esden/open-bldc/source/libgovernor/README

Open-BLDC high speed debug protocol library.
