esden/open-bldc/source/firmware/README

This is firmware for the Open-BLDC (http://open-bldc.org)

Compilation
-----------

 $ make

Flashing
--------

1) Run OpenOCD in the directory where the *.bin file is located:

 $ openocd -f interface/flossjtag.cfg \
           -f board/open-bldc.cfg

NOTE: flossjtag.cfg is only an example. If you use another JTAG adapter
      choose a different config file.

2) Connect to OpenOCD, flash and reset the target:

 $ telnet localhost 4444
 > reset halt
 > flash write_image erase open-bldc.hex
 > reset
