esden/open-bldc/source/firmware/src/comm_process_hardware.c

/*
 * Open-BLDC - Open BrushLess DC Motor Controller
 * Copyright (C) 2010 by Piotr Esden-Tempski <piotr@esden.net>
 *
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
 * You should have received a copy of the GNU General Public License
 * along with this program.  If not, see <http://www.gnu.org/licenses/>.
 */

/**
 * @file   comm_process.c
 * @author Piotr Esden-Tempski <piotr@esden.net>
 * @date   Tue Aug 17 02:06:02 2010
 *
 * @brief  Commutation control userspace process implementation.
 *
 * This process is being called periodically from the main while loop and
 * generates commutation events.
 */

#include "types.h"

#include <lg/gpdef.h>
#include <lg/gprotc.h>

#include "gprot.h"
#include "driver/led.h"
#include "driver/debug_pins.h"
#include "driver/bemf_hardware_detect.h"
#include "comm_tim.h"
#include "comm_process.h"

#include "sensor_process.h"

volatile bool *comm_process_trigger;

/**
 * Internal state of the comm process struct.
 */
struct comm_process_state {
	volatile bool rising;	/**< Waiting for rising or falling edge of BEMF */
	bool closed_loop;	/**< Running in closed loop control flag */
	u32 detect_count;
};

/**
 * Comm process parameters
 *
 * @todo clean up documentation
 */
struct comm_params {
	s16 spark_advance;	 /**< advance commutation relative to calculated time */
	u16 direct_cutoff;	 /**< distance from the last calc time that makes the new invalid */
	u16 direct_cutoff_slope; /**< what is the control slope when outside the direct control window */
	u16 iir;		 /**< IIR value for the commutation time */
	u16 hold_off;		 /**< how many bemf samples after a commutation should be dropped */
};

static struct comm_process_state comm_process_state;	/**< Internal state instance */
struct comm_data comm_data;			/**< Public data instance */
struct comm_params comm_params;			/**< Parameters */
s32 new_cycle_time;				/**< New commutation time
						  temporary variable, @todo
						  remove */

bool comm_process_time_valid(void);

/**
 * Initialize commutation process
 */
void comm_process_init(void)
{

	gpc_setup_reg(GPROT_COMM_TIM_SPARK_ADVANCE_REG_ADDR,
		      (u16 *) & (comm_params.spark_advance));
	gpc_setup_reg(GPROT_COMM_TIM_DIRECT_CUTOFF_REG_ADDR,
		      &(comm_params.direct_cutoff));
	gpc_setup_reg(GPROT_COMM_TIM_IIR_POLE_REG_ADDR, &(comm_params.iir));

	comm_process_trigger = &bemf_hd_data.trigger;

	comm_process_state.rising = true;
	comm_process_state.closed_loop = false;
	comm_process_state.detect_count = 0;

	comm_data.bemf_crossing_detected = false;
	comm_data.calculated_freq = 0;
	comm_data.in_range_counter = 0;

	comm_params.spark_advance = COMMP__SPARK_ADVANCE;
	comm_params.direct_cutoff = 10000;
	comm_params.direct_cutoff_slope = 20;
	comm_params.iir = COMMP__IIR;
	comm_params.hold_off = 1;
}

/**
 * Reset commutation process internal state.
 */
void comm_process_reset(void)
{
	comm_process_state.detect_count = 0;
}

/**
 * Commutation process configuration
 *
 * @param rising true selects rising edge of bemf and false the falling edge of
 * the BEMF
 */
void comm_process_config(bool rising)
{
	comm_process_state.rising = rising;
}

/**
 * Reset and configure commutation process.
 *
 * @param rising true selects rising edge of BEMF and false the falling edge of
 * the BEMF
 */
void comm_process_config_and_reset(bool rising)
{
	comm_process_state.rising = rising;
}

/**
 * Switch on the closed loop control system
 */
void comm_process_closed_loop_on(void)
{
	comm_process_state.closed_loop = true;
}

/**
 * Switch off the closed loop control system
 */
void comm_process_closed_loop_off(void)
{
	comm_process_state.closed_loop = false;
}

/**
 * Main periodic body of the commutation process
 */
void run_comm_process(void)
{
	u32 big_freq = comm_tim_data.freq;
	u16 new_freq = (comm_tim_data.curr_time -
		comm_tim_data.prev_time);
	u32 big_new_freq = new_freq;

	big_new_freq += comm_params.spark_advance;

#ifdef PWM_SCHEME_12STEP
	big_new_freq /= 4;
#else
	big_new_freq /= 2;
#endif

	big_freq = big_freq * comm_params.iir;
	big_new_freq = (big_freq + big_new_freq) / (comm_params.iir + 1);

	if (comm_process_time_valid()) {
		comm_tim_data.freq = big_new_freq;
		(void)gpc_register_touched(GPROT_COMM_TIM_FREQ_REG_ADDR);

		comm_tim_update_freq();

		OFF(DP_EXT_SCL);
	} else {
		comm_tim_update_freq();
		OFF(DP_EXT_SCL);
	}

	if (comm_process_state.closed_loop) {

		comm_data.bemf_crossing_detected = true;
		comm_tim_trigger_comm = true;
	}
}

bool comm_process_time_valid(void) {
	/*
	 * check if we are in the range where the comm timer is able
	 * to operate
	 */
	if ((comm_tim_data.update_count > 1) ||
		((comm_tim_data.update_count == 1) &&
			(comm_tim_data.curr_time > comm_tim_data.prev_time))) {
		return false;
	}

	/*
	 * check if we are far away from the edge of the maximal time
	 * comm timer can work in so that we have enough freedom to operate
	 */
	if ((comm_tim_data.curr_time -
			comm_tim_data.prev_time) > (65535 - 1000)) {
		return false;
	}

	return true;
}

/**
 * Do we have enough information for calculating commutation times?
 */
bool comm_process_ready(void)
{

	if (!comm_process_time_valid()) {
		comm_process_state.detect_count = 0;
		return false;
	}

	comm_process_state.detect_count++;

	/*
	 * check if we detected enough valid transitions that we
	 * are comfortable to proceed with closed loop
	 */
	if (comm_process_state.detect_count < 20) {
		return false;
	}

	return true;
}
