esden/open-bldc/source/firmware/src/control_process.c

/*
 * Open-BLDC - Open BrushLess DC Motor Controller
 * Copyright (C) 2010 by Piotr Esden-Tempski <piotr@esden.net>
 *
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
 * You should have received a copy of the GNU General Public License
 * along with this program.  If not, see <http://www.gnu.org/licenses/>.
 */

/**
 * @file   control_process.c
 * @author Piotr Esden-Tempski <piotr@esden.net>
 * @date   Tue Aug 17 01:27:42 2010
 *
 * @brief  User space control process implementation.
 *
 * This process is being called periodically from the main while loop and
 * handles the high level control of the system. The main state machine of the
 * whole controller is implemented here.
 */

#include "types.h"
#include "config.h"

#include "comm_tim.h"
#include "pwm/pwm.h"
#include "comm_process.h"
#include "driver/led.h"

#include "cp_spinup.h"
#include "cp_idle.h"
#include "cp_aligning.h"
#include "cp_spinning.h"
#include "cp_error.h"

#include "control_process.h"

/* local function forward declarations */
static void control_process_handle_cb_state(enum control_process_cb_state cb_ret);

/* Note: control_process_<state>_cb is defined in external
 * <state> strategy that implements <state>.h.
 */

static struct control_process control_process;	/**< Internal state struct instance */

/**
 * Control process state callback function pointer definition.
 */
typedef enum control_process_cb_state (*cps_callback) (struct control_process *
						       cps);

/**
 * Control process event hook slot definition.
 */
struct cps_event_hook {
	bool *trigger;		                          /**< Trigger the callback should be called upon */
	cps_callback callback;		                  /**< Pointer to the callback function */
	/*@null@*/ cps_callback state_in_callback;	  /**< Pointer to the callback function */
	/*@null@*/ cps_callback state_out_callback;       /**< Pointer to the callback function */
};

static struct cps_event_hook control_process_cb_hook_register[cps_num_states];

/* function implementations */

/**
 * Register a callback function for given control process state.
 *
 * These are:
 * (see @ref control_process.h -> control_process_state)
 *
 * - cps_error
 * - cps_idle
 * - cpd_aligning
 * - cps_spinup
 * - cps_spinning
 *
 * The number of existing process states (currently 5) is stored in
 * cps_num_states.
 *
 * In order to register a callback for a specific process state, use
 * @code
 * control_process_register_cb(<state>, <callback fun>);
 * @endcode
 *
 * Example from @ref control_process_init():
 * @code
 * control_process_register_cb(cps_idle,
 * 			       control_process_idle_trigger,
 * 			       control_process_idle_cb);
 * @endcode
 */
void control_process_register_cb(enum control_process_state cp_state,
				 bool * trigger,
				 cps_callback callback_fun,
				 cps_callback state_in_callback_fun,
				 cps_callback state_out_callback_fun)
{
	control_process_cb_hook_register[cp_state].trigger = trigger;
	control_process_cb_hook_register[cp_state].callback = callback_fun;
	control_process_cb_hook_register[cp_state].state_in_callback =
	    state_in_callback_fun;
	control_process_cb_hook_register[cp_state].state_out_callback =
	    state_out_callback_fun;
}

/**
 * Initialize internal state of the control process
 * Also calls callback init functions for every
 * process state.
 */
void control_process_init(void)
{
	control_process_reset();

	cp_idle_init();
	cp_spinup_init();
	cp_aligning_init();
	cp_spinning_init();
	cp_error_init();
}

/**
 * Reset the internal state of the control process.
 * Also calls callback reset functions for every
 * process state.
 */
void control_process_reset(void)
{
	cp_idle_reset();
	cp_spinup_reset();
	cp_aligning_reset();
	cp_spinning_reset();
	cp_error_reset();

	control_process.state = cps_idle;
	control_process.ignite = false;
	control_process.kill = false;
	control_process.bemf_crossing_counter = 0;
	control_process.bemf_lost_crossing_counter = 0;
}

/**
 * Trigger motor ignition
 */
void control_process_ignite(void)
{
	control_process_reset();
	comm_tim_reset();
	control_process.ignite = true;
}

/**
 * Immediately kill the motor
 *
 * Calling this function will immediately stop sending any signals to the power
 * stage. Can be used for example when a fault is being detected.
 */
void control_process_kill(void)
{
	comm_process_closed_loop_off();
	pwm_off();
	comm_tim_trigger_comm = false;
	comm_tim_trigger_comm_once = false;
	control_process.kill = true;
	control_process.state = cps_idle;
}

/**
 * Main periodic control process body.
 *
 * It implements the main state machine of the motor controller.
 *
 * Calls registered callback functions according to the current
 * state of the control process.
 * If a callback function returns an invalid code, the callback
 * function for state cps_error is called.
 *
 * Exits the closed loop and kills the control process if a
 * callback function returns cps_cb_exit_control.
 *
 * If the control process state changes during a callback function,
 * the last state's state_out_callback and the current state's
 * state_in_callback function is called.
 *
 * Order is:
 *
 *   current state -> callback (sets next state)
 *   -> run_control_process notices state transition
 *   current state -> state out callback
 *   next state    -> state in  callback
 *   -> next call of run_control_process
 *   next state    -> callback
 *
 */
void run_control_process(void)
{
	enum control_process_cb_state cb_ret = cps_cb_error;
	static enum control_process_state last_state = cps_idle;

	if (*control_process_cb_hook_register[control_process.state].trigger) {
		*control_process_cb_hook_register[control_process.state].
		    trigger = false;
		cb_ret =
		    control_process_cb_hook_register[control_process.state].
		    callback(&control_process);
	}

	control_process_handle_cb_state(cb_ret);

	if (last_state != control_process.state) {
		// Callback changed state of control process, so
		// if set, we call the last state's state_out_callback ...
		if (control_process_cb_hook_register[last_state].
		    state_out_callback) {
			cb_ret =
			    control_process_cb_hook_register[last_state].
			    state_out_callback(&control_process);
			control_process_handle_cb_state(cb_ret);
		}
		// ... and the next state's state_in_callback
		if (control_process_cb_hook_register[control_process.state].
		    state_in_callback) {
			cb_ret =
			    control_process_cb_hook_register[control_process.
							     state].
			    state_in_callback(&control_process);
			control_process_handle_cb_state(cb_ret);
		}
	}

	last_state = control_process.state;
}

/**
 * Internal handler for reacting on the states returned
 * by state callback functions.
 */
void control_process_handle_cb_state(enum control_process_cb_state cb_ret)
{
	if (cb_ret == cps_cb_continue) {
		// Everything is fine
		return;
	}

	// Could also be implemented in error handling strategy:
	if (cb_ret == cps_cb_exit_control) {
		// Callback wants process to exit closed loop
		control_process_kill();
	} else if (cb_ret == cps_cb_resume_control) {
		// Callback wants us to enter closed loop
		comm_process_closed_loop_on();
	}

}
