esden/open-bldc/source/qgovernor/governormaster.cpp

/*
 * qgovernor - QT based Open-BLDC PC interface tool
 * Copyright (C) 2010 by Piotr Esden-Tempski <piotr@esden.net>
 *
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
 * You should have received a copy of the GNU General Public License
 * along with this program.  If not, see <http://www.gnu.org/licenses/>.
 */

extern "C" {
#include <lg/types.h>
#include <lg/gpdef.h>
#include <lg/gprotm.h>
}

#include "governormaster.h"

extern "C" {
void gpm_output_trigger(void *data);
void gpm_log_callback(void *data);
void gpm_register_changed(void *data, u8 addr);
void gpm_string_received(void *data, char *string, int size);
}

GovernorMaster::~GovernorMaster()
{
  delete reglog;
}

GovernorMaster::GovernorMaster()
{
    gpm_init(gpm_output_trigger, static_cast<void *>(this), gpm_register_changed, static_cast<void *>(this));
    gpm_set_string_received_callback(gpm_string_received, static_cast<void *>(this));
}

signed short GovernorMaster::pickupByte()
{
    return gpm_pickup_byte();
}

int GovernorMaster::sendSet(unsigned char addr, unsigned short data)
{
    return gpm_send_set(addr, data);
}

int GovernorMaster::sendGet(unsigned char addr)
{
    return gpm_send_get(addr);
}

int GovernorMaster::sendGetCont(unsigned char addr)
{
    return gpm_send_get_cont(addr);
}

int GovernorMaster::sendGetVersion(void)
{
    return gpm_send_get_version();
}

unsigned short GovernorMaster::getRegisterMapValue(unsigned char addr)
{
    return gpm_get_register_map_val(addr);
}

int GovernorMaster::handleByte(unsigned char byte)
{
    return gpm_handle_byte(byte);
}

void GovernorMaster::outputTriggerCB()
{
    emit outputTriggered();
}

void GovernorMaster::registerChangedCB(unsigned char addr)
{
    emit registerChanged(addr);
}

void GovernorMaster::newLog(const QString &name)
{
  reglog = new QGLogger(name);
  gpm_set_log(&gpm_log_callback, static_cast<void *>(this));
}

void GovernorMaster::stringReceivedCB(char *string, int size)
{
    emit stringReceived(QString(string));

    size = size; /* we are ignoring size I think that it is a bad idea :/ */
}

// The libgovernor callbacks use a void pointer to keep the address of
// the GovernorMaster instance; these callbacks then re-cast it to
// call the methods on the right instance.  

extern "C" {
void gpm_output_trigger(void *data)
{
    static_cast<GovernorMaster *>(data)->outputTriggerCB();
}

void gpm_register_changed(void *data, u8 addr)
{
    static_cast<GovernorMaster *>(data)->registerChangedCB(addr);
}

void gpm_log_callback(void *data)
{
  static_cast<GovernorMaster *>(data)->reglog->
    writeRegisters(&gpm_get_register_map_val);
}

void gpm_string_received(void *data, char *string, int size)
{
    static_cast<GovernorMaster *>(data)->stringReceivedCB(string, size);
}

}
