esden/open-bldc/source/firmware/test/blink_main.c

/*
 * Open-BLDC - Open BrushLess DC Motor Controller
 * Copyright (C) 2009 by Piotr Esden-Tempski <piotr@esden.net>
 *
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
 * You should have received a copy of the GNU General Public License
 * along with this program.  If not, see <http://www.gnu.org/licenses/>.
 */

/**
 * @file   blink_main.c
 * @author Piotr Esden-Tempski <piotr@esden.net>
 * @date   Tue Aug 17 01:47:20 2010
 *
 * @brief  Blink test implementation
 *
 */

#include <libopencm3/stm32/f1/gpio.h>

#include "types.h"
#include "driver/mcu.h"
#include "driver/led.h"

/**
 * Crude delay implementation.
 *
 * Just burn some MCU cycles
 *
 * @param delay "time" to wait
 */
static void my_delay(unsigned long delay)
{

	while (delay != 0) {
		delay--;
		__asm("nop");
	}
}

/**
 * Turn on LED by id.
 *
 * @param id LED id
 */
static void led_on(int id)
{
	switch (id) {
	case 0:
		ON(LED_RED);
		break;
	case 1:
		ON(LED_GREEN);
		break;
	case 2:
		ON(LED_BLUE);
		break;
	case 3:
		ON(LED_ORANGE);
		break;
	}
}

/**
 * Turn off LED by id
 *
 * @param id LED id
 */
static void led_off(int id)
{
	switch (id) {
	case 0:
		OFF(LED_RED);
		break;
	case 1:
		OFF(LED_GREEN);
		break;
	case 2:
		OFF(LED_BLUE);
		break;
	case 3:
		OFF(LED_ORANGE);
		break;
	}
}

/**
 * Blink test main function
 *
 * @return Nothing really...
 */
int main(void)
{
	int i, j, led_id;

	mcu_init();
	led_init();

	led_id = 0;

	while (true) {
		for (j = 0; j < 20; j++) {
			for (i = 0; i < 125; i++) {
				led_on(led_id);
				my_delay((unsigned long)(50 * j));
				led_off(led_id);
				my_delay((unsigned long)(1200 - 50 * j));
			}
		}
		for (j = 0; j < 20; j++) {
			for (i = 0; i < 125; i++) {
				led_off(led_id);
				my_delay((unsigned long)(200 + 50 * j));
				led_on(led_id);
				my_delay((unsigned long)(1000 - 50 * j));
			}
		}
		led_off(led_id);
		led_id++;
		led_id %= 4;
	}
}
