esden/open-bldc/source/utils/olconf/src/register_config_builder.cpp

/*
 * olconf - yamlgen based Open-BLDC configuration header generator
 * Copyright (C) 2010 by Tobias Fuchs <twh.fuchs@gmail.com>
 *
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
 * You should have received a copy of the GNU General Public License
 * along with this program.  If not, see <http://www.gnu.org/licenses/>.
 */

#include <olconf/register_config_builder.hpp>
#include <olconf/register_config.hpp>
#include <olconf/register_group_config.hpp>
#include <olconf/abstract_register_config_runner.hpp>

#include <yamlgen/config_node.hpp>
#include <yamlgen/abstract_config_runner.hpp>
#include <yamlgen/exception/builder_exception.hpp>


namespace YAMLGen { 
namespace OBLDC { 

void
RegisterConfigBuilder::parse(ConfigNode const & config)
{
	ConfigNode root;
	ConfigNode::const_iterator root_it = config.find("config_root");
	if(root_it != config.end()) { 
		root = (*root_it).second;
	}
	else { 
		throw BuilderException("Could not find config_root", config.context());
	}
	parse_partial(root);
}

void
RegisterConfigBuilder::parse_partial(ConfigNode const & config_node)
{
	ConfigNode::const_iterator it_groups  = config_node.begin(); 
	ConfigNode::const_iterator end_groups = config_node.end(); 
	for(; it_groups != end_groups; ++it_groups) 
	{ 
		RegisterGroupConfig group = RegisterGroupConfig((*it_groups).first);
		
		ConfigNode group_config = (*it_groups).second;
		group.set_properties(group_config.values());

		if(group.has_property("description")) { 
			group.set_description(group["description"]);
		}
		
		ConfigNode registers = (*it_groups).second; 
		ConfigNode::const_iterator reglist = registers.find("registers"); 
		if(reglist == registers.end()) { 
			throw BuilderException("No entry 'registers:' found", registers.context());
		}
		ConfigNode register_list = (*reglist).second; 
		
		ConfigNode::const_iterator it_regs  = register_list.begin(); 
		ConfigNode::const_iterator end_regs = register_list.end(); 
		
		for(; it_regs != end_regs; ++it_regs) { 
			RegisterConfig reg = RegisterConfig((*it_regs).first);
			ConfigNode properties = (*it_regs).second; 
			reg.set_properties(properties.values());
			
			if(!reg.has_property("register")) { 
				throw BuilderException("No property 'register: <index>' found", 
															 properties.context());
			}
			if(!reg.has_property("label")) { 
				throw BuilderException("No property 'label: <string>' found", 
															 properties.context());
			}
			
			WidgetConfig widget; 
			if(properties.has_node("widget")) { 
				ConfigNode widget_properties = properties.node("widget");
				widget.set_properties(widget_properties.values());
				if(!widget.has_property("class")) { 
					throw BuilderException("No property 'class: <string>' found", 
																 widget_properties.context());
				}
			} 
			else {
				throw BuilderException("No property 'widget: <widget attribs>' found", 
															 properties.context());
			}
			reg.set_widget(widget); 
			
			group.add_register(reg); 
		}
		m_register_groups.push_back(group);
#if defined(LOG) && LOG == DEBUG
		group.log(); 
#endif
	}
}

void 
RegisterConfigBuilder::run(AbstractRegisterConfigRunner & runner) 
{
	runner.run(this); 
}

} /* namespace OBLDC */
} /* namespace YAMLGen */
