esden/open-bldc/(commit log)

2008-12-13 First very basic shot at the schematics of open-bldc
    [open-bldc.sch]
2008-12-13 Splitted ground around the shunt. So it is easier later on.
    [open-bldc.sch]
2008-12-13 Added i2c connector
    [open-bldc.sch]
2008-12-14 Now we are using AT90PWM3 instead of atmega8. Additionally overcurrent detection happenѕ discretly now.
    - Renamed GND1 in the symbol of at90pwm to GND.
    - Exchanged atmega8 with AT90PWM3
    - Adapted all circuits to use the examples in AVR 492 Application Note
    - We can measure current but are using an opamp to detect overcurrent instantly
    - We now have 4 indicator LED's (I love LED's ^^)
    - Serial connector removed because it is not needed anymore. Serial is on the same pins as the programmer.
    [open-bldc.sch]
2008-12-14 Added the url's of the Application Notes used in the circuit design to the README
2008-12-15 Changed again everything around. Now the uc is an atmega168, the current measurement is gone, back to a similar to the old schematic bemf circuit, compleatly new phase control with drivers and fets
    [open-bldc.sch]
2008-12-15 Many improvements! Changed connectors to smd pads, added battery voltage measurement circuit, added another row of fets, power and phases are pads now, moved led's to other pins of the atmega, and pr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
    [open-bldc.sch]
2008-12-16 Changed the resistors of the commutation detection and added capacitors to smooth the signals, connected the lower side of the phase drivers to GND, fixed most of the ERC warnings, Quarz replaced wit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
    [open-bldc.sch]
2008-12-16 Changed all resistor and capacitor packages to 0402 and LED packages to 0603.
    [open-bldc.sch]
2008-12-16 Changed the resistors and capacitors back to 0603 ... the 0402 are too small after all. ^^ Changed R18 to 10k
    [open-bldc.sch]
2008-12-26 Cleaned up the names of R's and C's so that they are in a somehow sane order. And probably some more other cleanups.
    [open-bldc.sch]
2008-12-26 Added a first shot at the board layout and routing of Open BLDC. There are still some DRC Errors for Stop Mask that may have to be resolved.
    In this version of the board the low and high side fets are placed on two different sides of the board. (has to be discussed)
    [open-bldc.brd]
2008-12-26 Added "Fet drivers" and "N-Channel vs N- and P-Channel MOSFETs" sections to design discussions. (TODO: these sections need proper explanations from electrical engeneers or someone with knowledge why 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
2008-12-26 Added a board layout with all fets on one side. This board layout is not finished, but added as reference and basis for further development.
    [open-bldc-fets-one-side.brd]
2008-12-26 Moved current schematics and board layouts to a new subdirectory. Because I want to start working on alternative boards.
    [open-bldc-fets-one-side.brd, open-bldc.brd, open-bldc.sch]
2008-12-26 Added copyright and license notes to the board layouts of open-bldc-normal.
    [open-bldc-fets-one-side.brd, open-bldc.brd]
2008-12-26 Added schematics of the open-bldc mini version.
    [open-bldc.sch]
2008-12-29 Rerouted everything from scratch to make the board smaller. Now it is 26mm by 60mm instead of 30 by 100. It is a big improovement.
    [open-bldc.brd]
2009-04-11 Fixed License strings in the schematics and pcb layouts
    [open-bldc.brd, open-bldc.sch]
2009-04-19 Added test code for the open-bldc breadboard prototype.
2009-04-19 Now generating real 6Step PWM signal!
2009-04-20 Moved pwm initialization into it's own function.
2009-04-20 First working uart tx.
2009-04-22 Moved pwm and usart related stuff from main.c to their own files.
2009-04-25 Added more led debug blocks. Enabled com handle block.
2009-04-25 Increased resolution of enforced comm timer setting.
2009-04-25 PWM duty cycle can now be changed through usart.
2009-04-25 Moved tim1_trg_com_irq_handler to the pwm module.
2009-04-25 Removed all the empty interrupt handler routines.
2009-04-26 Some little tweaks. (Maiden run: result the motor turns!)
    Increased the resolution of forced commutation. Increased the resolution
    of pwm. Some little parameter tweaks. The motor, in most cases, starts
    to turn by it self.
2009-04-27 Moved old pcb designs to discarded folder. Not deleting to leave it for reference.
    [open-bldc-fets-one-side.brd, open-bldc.brd, open-bldc.sch]
2009-04-27 First steps in redesigning the hardware to use stm32.
    [open-bldc.brd, open-bldc.sch]
2009-04-27 Fixed license.
    [open-bldc.brd, open-bldc.sch]
2009-04-27 Added new commutation detection circuitry. And small fixes.
    [open-bldc.brd, open-bldc.sch]
2009-04-28 Work on the commutation detection circuitry.
    [open-bldc.brd, open-bldc.sch]
2009-04-29 Refactoring: Moved the commutation algorithm and phase setting functions to their own modules. Created config.h with compile time settings.
    This should it make much eaiser to implement different pwm schemes that
    can be tested against each other. And compile time configuration is now
    a bit easier due to config.h.
2009-05-01 Renamed current pwm scheme to it's real name.
2009-05-01 Added table with pwm scheme zone configurations.
2009-05-01 Removed the freewheeling stuff again. It just does not work.
    I need to take a deeper look into it later.
    [pwm.c, usart.c]
2009-05-01 Implemented 12step pwm_on_pwm and 6step on_pwm schemes.
2009-05-01 Added a reload of TIM1 when commutating to get rid of a wierd oscilating noise caused by non aligned PWM signals.
2009-05-03 Implemented pwm_on scheme.
2009-05-04 Changed enabled PWM scheme to 12step pwm_on_pwm. Should stay default in the repo.
2009-05-04 Added first test code for pwm triggered adc. Commutation detection we are coming!
2009-05-06 Added some svg graphics depicting the different pwm schemes.
2009-05-06 Added a voltage divider, and now using two schottkey diodes for cutoff in the comm detect circuitry.
    We may have to measure the phase voltages in pwm on times so the voltage
    divider will be very useful. The ADC seems to be robust enough to
    withstand the voltage overshoot when using schottkey diodes for upper
    voltage cutoff.
    [open-bldc.brd, open-bldc.sch]
2009-05-08 Added an optional filter capacitor to bemf circuitry, added current sensing and replaced voltage regulator with a dual channel 3v3, 5v.
    [open-bldc.brd, open-bldc.sch]
2009-05-14 Ported Open-BLDC to libstm32 3.0.0
2009-05-21 Added pullups to jtag interface. Added USB connector and USB disconnect circuit.
    [open-bldc.brd, open-bldc.sch]
2009-06-16 Added current sensing circuitry to phases. Added connectors between the logic board and power stage. Some other minor changes.
    [open-bldc.brd, open-bldc.sch]
2009-06-16 Replaced the SO8 Mosfets with D2PAK. Now only one bridge row instead of three.
    [open-bldc.brd, open-bldc.sch]
2009-06-16 Replaced the edge connectors between logic and powerstage with 1.27mm single pinheaders. These will be put on each side of the logic board. This is mechanically more robust. The smaller pitch is also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
    [open-bldc.brd, open-bldc.sch]
2009-06-16 Fixed the LED connections to the MCU.
    [open-bldc.brd, open-bldc.sch]
2009-06-17 Replaced bootstrap caps with tantals, 1uF with smaller packages, elko with two tantals (last one is mechanically more robust).
    [open-bldc.brd, open-bldc.sch]
2009-06-17 Replaced the strange 3v3, 5v voltage regulator with two single, more common, ones.
    [open-bldc.brd, open-bldc.sch]
2009-06-17 Replaced JTAG and I2C connectors with 1.27mm pitch edge connectors. Moved USART lines from the JTAG connector to it's own one.
    [open-bldc.brd, open-bldc.sch]
2009-06-18 Replaced the single resistors for LED's with a resistor array. (more such replacements to come) Replaced three of the LED's with one RGB LED.
    [open-bldc.brd, open-bldc.sch]
2009-06-18 Replaced some more resistors with arrays to optimize space usage.
    [open-bldc.brd, open-bldc.sch]
2009-06-18 Moved the 3V3 regulator behind 5V regulator to decrese power usage.
    [open-bldc.brd, open-bldc.sch]
2009-06-18 BEMF and phase current are now selectable using smd jumpers.
    [open-bldc.brd, open-bldc.sch]
2009-06-18 Fixed typo in copyright/license notice.
    [open-bldc.sch]
2009-06-18 Reordered the crircuitry a bit. Designated Powerstage and Logic board circuitry parts.
    [open-bldc.sch]
2009-06-18 Reordered pins on the i2c connector. Added 3V3 and 5V to the usart connector.
    [open-bldc.brd, open-bldc.sch]
2009-06-18 Removed external oscilator. We do not need it. The maximum clock can be acheved also with the internal clock source.
    [open-bldc.brd, open-bldc.sch]
2009-06-18 Cleaned up the power supply and reset circuitry of the STM32.
    [open-bldc.brd, open-bldc.sch]
2009-06-18 Added power supply circuit for the power stage.
    [open-bldc.brd, open-bldc.sch]
2009-06-18 Removed rectification diodes from current sensor circuitry.
    [open-bldc.brd, open-bldc.sch]
2009-06-18 Removed HAL pins from the powerstage to logic connector. We really can do everything sensorless. Added 12V and powerstage id instead.
    [open-bldc.brd, open-bldc.sch]
2009-06-18 Moved LED1 and LED2 to pwm output pins for some fading fun.
    [open-bldc.brd, open-bldc.sch]
2009-06-18 Removed usb_disc circuitry. We don't really need it. Left only the pullup so that open-bldc gets detected as a full speed device.
    [open-bldc.brd, open-bldc.sch]
2009-06-18 Moved USB pullup behind the series resistor where it should be. Moved the pins of i2c back to the old version to match UAVP NG order. Renamed USB Connector to U3.
    [open-bldc.brd, open-bldc.sch]
2009-06-18 Removed brd file. It has to be remade from scratch anyways.
    [open-bldc.brd]
2009-06-18 Moved shottkey voltage clamping diodes from bemf circuitry to the logic board to protect the I/BEMF lines.
    [open-bldc.sch]
2009-06-18 Replaced usart connector with molex microblade.
    [open-bldc.sch]
2009-06-19 Replaced the 3v3 regulator with LP2992 to save space.
    [open-bldc.sch]
2009-06-19 Added 12V charge pump for bridge driver power supply.
    [open-bldc.sch]
2009-06-19 Removed lowpass capacitors from the current sensors. It is not needed, we use the filter pin on the sonsors.
    [open-bldc.sch]
2009-06-19 Added buffer opamps to I/BEMF and I_SENSE lines coming from the powerstage.
    [open-bldc.sch]
2009-06-19 Added jumpers to make it possible to disconnect the opamps for testing. Also added a 2way jumper to the power supply of the bridge drivers to make testing that also easier.
    [open-bldc.sch]
2009-06-19 Moved the complete schematic to a subdirectory so that we can start creating independant projects for the logic board and power stage board.
    [open-bldc.sch]
2009-06-21 Added STM32f101x-LQFP48 to the library. Preparing to replace the one in the schematic with a single piece.
2009-06-21 Some little fixes based on ERC check.
    [open-bldc.sch]
2009-06-21 Some little tweeks on the STM32 symbol in the library. Replaced the scattered STM32 symbol with the single one contained in the open-bldc.lbr.
    [open-bldc.sch]
2009-06-21 Connected USB_+5V to the +5V rail.
    [open-bldc.sch]
2009-06-21 Replaced single solder jumpers with smaller ones. The same style as the SJ2 ones.
    [open-bldc.sch]
2009-06-21 Added an HC49UP crystal. As it seems we need an external crystal at the end. The internal 8MHz quarz is not exact enough for USB and the maximal clock one can get out of it is 64MHz and not 72Mhz. :(
    [open-bldc.sch]
2009-06-21 Connected SHDN pin of the bridge driver charge pump to gnd. Otherwise the charge pump is always off.
    [open-bldc.sch]
2009-06-21 Connected the PowerStage_ID to +3V3 is better then +12V. :)
    [open-bldc.sch]
2009-06-21 Added >NAME and >VALUE to ST662A charge pump symbol.
    [open-bldc.sch]
2009-06-21 Corrected series resistor values of the USART connector.
    [open-bldc.sch]
2009-06-21 Replaced the duo array resistors with single ones. Replaced the 0603 led resistor array with 1206.
    [open-bldc.sch]
2009-06-22 Corrected the name of the voltage divider net name (V_BATT) on the powerstage.
    [open-bldc.sch]
2009-06-22 Added another stabilization tantal for the bridge driver, +12V supply, rail.
    [open-bldc.sch]
2009-06-22 Renamed the nets behind current sensors to make routing easier.
    [open-bldc.sch]
2009-06-22 Started to layout the powerstage. (Some preliminary tests)
    [open-bldc-power.brd, open-bldc-power.sch]
2009-06-22 Layouted the bridge drivers on the powerstage.
    [open-bldc-power.brd]
2009-06-23 Nearly finished the first approach to the powerstage routing. The chargepump and global current sensor are not routed yet.
    [open-bldc-power.brd, open-bldc-power.sch]
2009-06-24 Routed the charge pump. Changed the orientation of the logic board, it seems to make everything much more streightforward. Reordered some pins on the power/sensor connector, to clean up some ugly mes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
    [open-bldc-power.brd, open-bldc-power.sch]
2009-06-24 Added Open-BLDC logo and some text to the board layout. Just for the fun of it.
    [open-bldc-power.brd]
2009-06-24 Corrected pinouts of the logic to power connection headers.
    [open-bldc.sch]
2009-06-24 Created eagle project for the logic board layout.
    [open-bldc-logic.brd, open-bldc-logic.sch]
2009-06-24 Added version string to the power stage layout.
    [open-bldc-power.brd]
2009-06-24 Replaced the crystal resonator with a small oscillator.
    [open-bldc-logic.brd, open-bldc-logic.sch, open-bldc.sch]
2009-06-24 Removed one of the big tantals on the logic board, replaced the opamp with a smaller tssop-14 version. Everything to save space. Layouting the logic board will be a nice puzzle anyways.
    [open-bldc-logic.brd, open-bldc-logic.sch, open-bldc.sch]
2009-06-24 Sorted all the components on the logic board together in functional pieces and made preliminary positioning.
    [open-bldc-logic.brd, open-bldc-logic.sch]
2009-06-26 Started routing. JTAG, I2C/PWM, USART and USB/CAN connectors are routed now.
    [open-bldc-logic.brd]
2009-06-26 Now the right logic brd layout should be commited. Removed the jumpers after the opamps to save even more space on the logic board.
    [open-bldc-logic.brd, open-bldc-logic.sch, open-bldc.sch]
2009-06-26 Further work on routing. LED's and the +5V of the USB/CAN connector are still missing. (nearly finished)
    [open-bldc-logic.brd, open-bldc-logic.sch]
2009-06-27 More routing work on the logic board. 5airwires to go.
    [open-bldc-logic.brd, open-bldc-logic.sch]
2009-06-28 Finished routing the logic board!
    [open-bldc-logic.brd]
2009-06-28 Added license string, restrict layer to the logo and some GND vias to the logic board.
    [open-bldc-logic.brd]
2009-06-28 Propagated the changes made in the logic circuit during routing.
    [open-bldc-power.brd, open-bldc-power.sch, open-bldc.sch]
2009-06-28 Finished routing the powerstage!
    [open-bldc-power.brd]
2009-06-28 Fixed wire angles in the logic board.
    [open-bldc-logic.brd]
2009-06-28 Incresed isolate on the powerstage.
    [open-bldc-power.brd]
2009-06-28 Corrected mechanical dimensions of the powerstage to metric.
    [open-bldc-power.brd]
2009-06-28 Corrected some mechanical data to match design rules and fixed angles in the powerstage.
    [open-bldc-power.brd]
2009-06-28 Added teardrop versions of the boards. Fixed some minor positioning on the logic board to make the board conform to the design rules after adding teardrops.
    [open-bldc-logic-teardrops.brd, open-bldc-logic.brd, open-bldc-power-teardrops.brd]
2009-06-29 Added version string to the logic board.
    [open-bldc-logic-teardrops.brd, open-bldc-logic.brd]
2009-06-29 Increased isolate on the logic board.
    [open-bldc-logic-teardrops.brd, open-bldc-logic.brd]
2009-06-30 Corrected the footprint of the LED resistor array.
    [open-bldc-logic.brd, open-bldc-logic.sch, open-bldc.sch]
2009-07-01 On public request started layouting a mini version of the powerstage using SO8 mosfets.
    [open-bldc-powermini.brd, open-bldc-powermini.sch]
2009-07-08 Added lots of vias to the powerboard and some to the logic board, so that the ground planes act less as antennas. Fixed layers in texts (above the copper layer it has to be resist not restrict) and m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
    [open-bldc-logic-teardrops.brd, open-bldc-logic.brd, open-bldc-logic.sch, open-bldc-power-teardrops.brd, open-bldc-power.brd, open-bldc-power.sch, open-bldc.sch]
2009-07-08 Added a jtag adapter to convert from the very common 20pin connector to the 10pin connector used on the open-bldc logic board.
    [jtag_adapter.brd, jtag_adapter.sch]
2009-07-09 added Makefiles for batch generation of gerbers and panels
    [layout.cfg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]
2009-07-10 Changed gerber generating makefile to use the teardrop version of the boards and added jtag_adapter board. Changed the layout of the panel to contain 4 open-bldc's on one panel and one jtag adapter.
    [layout.cfg]
2009-07-16 Added io protection resistors to the schematics. Still need to squeeze them into the logic board.
    They may not be really necessary but the atmel application note which is
    using the IR2101 bridge drivers has them. So to be sure that nothing
    goes wrong we really should add them. On the other hand I had some
    problems on the smd prototype of open-bldc which burnt the bridge
    drivers it is unlikely but this may be the reason for that. One can
    still bridge them when assembling.
    [open-bldc-logic.brd, open-bldc-logic.sch, open-bldc.sch]
2009-07-17 Squeezed in the 6 resistors for io protection of the bridge drive signals.
    Now we really should be ready for ordering the boards!
    [open-bldc-logic.brd]
2009-07-17 Updated the teardrop version of the logic board.
    [open-bldc-logic-teardrops.brd, open-bldc-logic.brd]
2009-07-26 Add README for Open-BLDC schematics/layouts implemented using gEDA/pcb.
2009-07-26 Add initial gschemrc file, set print size to A4.
2009-07-26 Add initial gsch2pcb.cfg, the config file for gsch2pcb.
    [gsch2pcb.cfg]
2009-07-26 Add initial schematics file for Open-BLDC, currently empty.
    [open-bldc.sch]
2009-07-26 Add project Makefile which can generate PDF/PS/Gerber/etc. output.
2009-07-26 Add some meta-data such as title, license, version to the schematics.
    [open-bldc.sch]
2009-07-26 Add a bunch of symbols to the schematics.
    [open-bldc.sch]
2009-07-26 Add parts of the "LED Indicators" schematics component.
    [open-bldc.sch]
2009-07-26 Add parts of the BEMF stuff.
    [open-bldc.sch]
2009-07-26 Add some parts of the power stage.
    [open-bldc.sch]
2009-07-26 Generate symbols before exporting schematics.
2009-07-26 Change pin order (to match physical chip) and add name/PDF/etc.
2009-07-26 Add some more schematics details, fix descriptions etc.
    [open-bldc.sch]
2009-07-26 Add an IR2101 IC.
    [open-bldc.sch]
2009-07-27 Fixed two typos in the STM32 symbol.
    [open-bldc-logic.sch, open-bldc.sch]
2009-07-27 Fixed a typo. ^^
    [gsch2pcb.cfg]
2009-07-27 Add symbol for the LQFP48 STM32F103xx microcontroller.
2009-07-27 Rearrange parts a bit.
    [open-bldc.sch]
2009-07-27 Add a symbol for a simple 10 pin JTAG connector.
2009-07-27 Add JTAG connector and surrounding stuff.
    [open-bldc.sch]
2009-07-27 Add LP2992 and surrounding parts.
    [open-bldc.sch]
2009-07-27 Add JP21 and JP22.
    [open-bldc.sch]
2009-07-27 Add ACS712 and surrounding components.
    [open-bldc.sch]
2009-07-27 Add ST662A and surrounding components.
    [open-bldc.sch]
2009-07-27 Rearrange some parts and make them more compact.
    [open-bldc.sch]
2009-07-27 Rearrange some more parts and make them more compact.
    [open-bldc.sch]
2009-07-27 Make JTAG connector smaller, fix cosmetics in other symbols.
2009-07-27 Adapt schematics for the now-smaller JTAG connector.
    [open-bldc.sch]
2009-07-27 Add symbol for a tiny 10-pin connector, the defaults are a bit too large.
2009-07-27 Use new tiny 10pin connectors.
    [open-bldc.sch]
2009-07-29 Started v0.2 version of the circuitry.
    [open-bldc.sch]
2009-07-29 Removed USB.
    [open-bldc.sch]
2009-07-30 Added CAN transceiver, replaced the I2C pinheader with molex connector, added jumpers to select between I2C and CAN on the former I2C connector.
    [open-bldc.sch]
2009-08-02 Add tiny 3-pin connector symbol.
2009-08-02 Use new tiny 3-pin connector, rearrange some components.
    [open-bldc.sch]
2009-08-02 Add a symbol for a dual solder-jumper (you can solder 1-2 or 2-3).
2009-08-02 Use the new solder-jumper (SJ2) symbol.
    [open-bldc.sch]
2009-08-02 Use 'refdes' tag where appropriate, not 'value'. Fix a symbol.
    [open-bldc.sch]
2009-08-02 Make schematics even more compact, fix typo in JP11/JP12.
    [open-bldc.sch]
2009-08-02 Rearrange more stuff and add an SMT32 to the schematic.
    [open-bldc.sch]
2009-08-02 Start populating STM32 pins.
    [open-bldc.sch]
2009-08-02 Add a dot to the NRST pin, it's active-low.
2009-08-02 Add some more circuitry around the STM32 symbol.
    [open-bldc.sch]
2009-08-02 Moved v0.2 schematic into eagle subdir. (preparing for gEDA support)
    [open-bldc.sch]
2009-08-08 Fixed breadboard prototype readme. It was still talking about the blink demo for the Olimex test board.
2009-08-09 Started the open-bldc firmware based on the breadboard prototype code. For the start it blinks with the red led.
2009-08-09 Factored out the LED stuff into the led module. Now all leds are blinking in sequence.
2009-08-09 Added usart support. Usart is echoing received data back to the sender and with every received byte the RED led is toggled.
2009-08-14 Added led toggling macros.
2009-08-14 Added pwm generation code.
2009-08-15 Enabled the tim1 comm interrupt.
2009-08-15 Now the phase pwm output should be force commutated with 73.24 Hz. (Just for testing)
2009-08-15 Switched to arm-elf compiler.
2009-08-15 Moved all pwm generation code into its own directory to clean up a bit.
2009-08-15 Now the LED stuff should be fixed finally...
    [led.h]
2009-08-16 Added some of the needed control through usart:
    <Space>: Emergency stop
    a: Commutate once
    b: Enable forced commutation timer
    c: Disable forced commutation timer
    h: Increase pwm duty cycle
    t: Decrese pwm duty cycle
    n: Decrese forced commutation frequency
    s: Increse forced commutation frequency
2009-08-19 Added OC4 to TIM1, it will become the trigger for ADC. The CC interrupt is not really needed but is nice for debugging purposes.
2009-08-19 Fixed LED output a little more. Now everything seems to work as it should. Even such a simple thing can also be messed up in infinite number of ways.
    [led.h, main.c, pwm.c]
2009-08-19 Red LED fading as heartbeat.
2009-08-21 Added BEMF commutation detection and timer based commutation time prediction. Some more keys for terminal control of BEMF based commutation.
    New keyboard keys:
    'r': Increse delay between pwm and adc trigger
    'l': Decrese delay between pwm and adc trigger
    'v': Increse BEMF detection threshhold
    'z': Decrese BEMF detection threshhold
    'p': Enable BEMF based commutation
2009-08-22 Added an IIR filter to the adc BEMF sampling.
2009-09-05 Bit of whitespace fixing.
    [adc.c, comm_tim.c]
2009-09-19 Upped the uart speed to 500kBaud we will need it for adc output monitoring very very soon.
2009-09-20 Started implementing governor (the PC tool for Open-BLDC) the backend of it will become libgovernor in the future to make it easy to create gui(s).
2009-09-20 Started implementing Open-BLDC protocol.
2009-09-20 Fixed some compiler warnings and an error preventing governor from compiling.
    [main.c]
2009-09-28 Added another footprint for the bridge driver. Thanks to David Brodski.
2009-10-21 Added so8 mosfet.
2009-10-21 Many improvements and changes.
    - Removed 5V linear vreg from the logic board.
    - Removed opamp from logic board.
    - Rerouted 5V supply of the uart connector and powerstage through a
    diodes.
    - Replaced JTAG connector with a molex microblade.
    - Replaced resistor array for LED's with discrete resistors.
    - Replaced D2PAK mosfets with SO8 type.
    - Removed unnecessary current sensor on phase C
    [open-bldc.sch]
2009-10-21 Added part representing the open-bldc logo.
2009-10-22 Splitted logic board and powerstage finally for good. :)
    [logic.sch, open-bldc.sch, pstage.sch]
2009-10-22 Replaced solderjumpers with fancy ones. Fixed footprint of some resistors.
    [logic.sch]
2009-10-22 Started layouting the logic board. (Too many changes to just modify the v0.1)
    [logic.brd]
2009-10-23 Some more layout work on the logic board. Replaced the BAS20 diodes with CDBU0130 0603 footprint diodes.
    [logic.brd, logic.sch]
2009-10-27 Finished routing the logic lines of the logic board. Only the two inner power layers missing.
    [logic.brd, logic.sch]
2009-10-27 Added GND and +3V3 layer. Little cosmetic cleanups. Almost finalized logic board V0.2.
    [logic.brd]
2009-11-16 Added digital encoder connector to the logic board.
    [logic.brd, logic.sch]
2009-11-16 Some more work on the so8 based powerstage.
    [pstage.brd, pstage.sch]
2009-11-18 Interrupt handlers are now weak pointers. Should make development bit easier.
2009-11-26 Layouted the silkscreen on the logic board to make a placeplan and maybe use it on future boards. ^^
    [logic.brd, logic.sch]
2009-12-14 Started a micro version of Open-BLDC.
    Features: One board, maximal size 67mm X 12mm
    Status: Schematic almost finalized, board layout in progress.
    [onepiece.brd, onepiece.sch]
2009-12-14 Added custom R, C and LED 0603 symbols. Looks much better.
2009-12-14 Updated to the new R,C and LED footprints.
    [onepiece.brd, onepiece.sch]
2009-12-15 Updated some footprints to make the silkscreen and placeplans doable. Still work in progress.
    [onepiece.brd, onepiece.sch]
2009-12-22 Fixed the place layer of the lm317 voltage regulators, and changed the footprint of the zener diodes to the new 0603 footprints. Some more layout work on the voltage regulator parts.
    [onepiece.brd, onepiece.sch]
2009-12-24 Updated footprints of Kimet-A and D parts to match the overall design. Updated molex picoblade footprint to match current design.
    [onepiece.brd, onepiece.sch]
2010-01-07 Changed led control from PP to OD. Should work better.
2010-01-07 Added led_fade PWM excersize.
    It is intended for better understanding the timer and PWM generation
    mechanisms in STM32.
2010-01-19 Some more work on onepiece routing.
    [onepiece.brd, onepiece.sch]
2010-02-02 Fixed a small unsignificant airwire in v0.2 logic.
    [logic.brd, logic.sch]
2010-02-02 Removed obsolete jtag pullup resistors.
    [logic.brd, logic.sch]
2010-02-03 Updated again to the new names of pretty-eagle-libs.
    [onepiece.brd, onepiece.sch]
2010-02-03 Added missing RST pullup.
    [onepiece.brd, onepiece.sch]
2010-02-03 Updated SOIC-8 footprint and replaced CAN transceiver.
    The SOIC-8 is now complient to IPC7351 standard.
    Replaced the CAN transceiver to SN65HVD230 because the small SOT32-8
    Maxim chip is only available in high quantities.
    [onepiece.brd, onepiece.sch]
2010-02-04 Removed LEDB and connected CAN_SLP to the STM.
    [onepiece.brd, onepiece.sch]
2010-02-24 Initial commit of qgovernor.
    qgovernor is a QT based Open-BLDC PC tool.
2010-02-24 Adapted governor to support floss-jtag serial interface.
    Governor now uses ftd2232 interface B for communication with the motor
    controller.
2010-03-22 Added blink test for open-bldc logic board.
    Should be useful for quick functionality testing of open-bldc.
2010-03-22 Switched to check unittest framework.
    Check is better then CUnit, it is isolating tests and catching
    segfaults. Also it supplies autoconf integration.
2010-03-22 Fixed check build and arm crosscompile.
    Unittests are now being built only in the check target. The coverage
    flags are now also only applied to the library and not to the unittests.
    This way when crosscompiling only the library gets built without the
    unittests which obvously wont compile or run.
2010-03-22 Some fixes on the register input handling.
    When a unconvertable register value is entered the value gets reverted
    now. When a register value gets changed only one message is being sent
    over the governor protocol.
    [governormaster.cpp, governormaster.h, mainwindow.cpp]
2010-03-22 Connection from sim to main added, bunch o fixes.
    The simulator register table is now alternating colors. Input log is not
    alternating colors anymore. Simulator window closes when disconnect
    button is pressed. Simulator register values get initialized properly.
    Simulator sends data back when master is sending read requests.
    [governorclient.cpp, governorclient.h, mainwindow.cpp, mainwindow.h, simulator.cpp, simulator.h]
2010-03-22 Switched bit flags for read/write for consistency.
2010-03-22 Hooked up simulator shutdown button.
2010-03-26 Added governor protocol test firmware.
    It currently contains a copy of the libgovernor client interface
    implementation which has to be removed and replaced with libgovernor
    itself.
    [exceptions.c, exceptions.h, gprot.h, led.c, led.h]
2010-03-27 Added povray board rendering files for onepiece.
2010-03-27 Removed obsolete breadboard prototype firmware.
2010-03-27 Removed the gprotc copy from governortest firmware.
    Replaced the copy of qprotc implementation from the gqvernortest
    firmware and replaced with the libgovernor.
    [types.h]
2010-03-27 Added halt and fixed obldc firmware makefiles.
    The open-bldc main firmware makefile was using old jtag and platform
    config files for make flash. Added make halt target to stop the target
    board using jtag too.
2010-03-31 Replaced old gprot implementation with libgovernor
    [gprot.h, main.c, usart.c]
2010-04-01 Fixed disconnecting from the ftdi device.
    Now the ftdi read thread is being closed properly when disconnecting
    from a ftdi governor device.
    [governorftdi.cpp, governorftdi.h, mainwindow.cpp]
2010-04-01 UI refactoring.
    Added table view to contain governor backend tab and the Open-BLDC
    specific control interface.
    Removed the connect and disconnect buttons which got replaced by a
    checkable connect/disconnect menu item and toolbar button. Because of
    that also added a resource file containing the apropriate icons.
    [mainwindow.cpp, mainwindow.h]
2010-04-02 Added Open-BLDC UI.
    Added a UI for manipulating all values currently exported from the
    open-bldc firmware.
2010-04-03 Moved PWM comm trigger indicator to BLED, cycle 1.
2010-04-03 Lowered PWM frequency to 18kHz
2010-04-09 Forced comm off switches off all phases.
2010-04-09 Cleaned up pwm_off handling.
2010-04-09 Added pwm all lo/hi functions.
2010-04-13 Changed default PWM offset to 250.
    We realized that we have to sample in pwm on state and use half rail
    voltage as transition reference. Removing the caps on the bemf
    contitioning signals prevents ramping but you still get some jitter on
    the signal. 250 seems to be the right offset from the beginning of the
    pwm cycle to avoid hitting the jittering of the bemf signal when pwm
    goes high.
    [pwm.c]
2010-04-13 Simplified the next comm trigger calculation.
    Now as our sampling is working much better the next comm trigger timer
    calculation can be simplified. It seems to work way better.
2010-04-13 Sending back comm timer value using governor.
2010-04-13 Refactored Open-BLDC tab, added monitor checkboxes.
2010-04-13 Added ADC level coupling checkbox.
2010-04-14 Added comm timer calculation iir filter.
    Also exported the iir pole and direct control cutoff value to qgovernor.
2010-04-14 Corrected the adc level value for 12V rail voltage.
    [adc.c]
2010-04-14 Removed adc delay as it seems to be unnecessary.
2010-04-14 Fixed the comm_tim_freq calculation to run on 32 bit.
    Hopefully for good now.
    [comm_tim.c]
2010-04-15 Added debounce to comm detect, incleased sample time.
2010-04-15 Incleased comm timer prescaler, inreased startup rampup speed.
    Now you can use the closed loop controller to startup the motor.
2010-04-15 Added coarse comm timer adjust indication.
2010-04-20 Added a 32bit timer test firmware.
2010-04-20 Optimized msb tim isr to prevent interrupt skipping.
    [tim.c]
2010-04-20 Updated comments in the 32bit comm timer impl.
2010-04-22 Some improvements of the 32bit timer test.
2010-04-22 Switched on size optimization.
2010-04-27 Implemented comm detection with linear interpolation.
    This means that we use the previous adc value to calculate the real bemf
    zero crossing. It is a linearized approach which is not perfect but
    improves the stability greatly! The previous border was 3000rpm and the
    motor started to rpm swing and stall. Only with this change we reached
    4170rpm now at 12V and 4A, on a turingy SK4240-750.
    [adc.c, adc.h, comm_tim.c, gprot.h, mainwindow.cpp, mainwindow.h, pwm_scheme_6step_h_pwm_l_on.c, types.h]
2010-04-29 Added new obldc connector.
    This connector is intended for connecting powerstage to logic. It is
    based on a long discussion on the mailinglist on how to do that.
2010-05-03 Created logic v0.3 with the new connector.
    [logic.sch]
2010-05-04 Connected several pins on the connector to the microcontroller. Rearranged the following nets connected to the micro: SCL moved to pin 45 SDA moved to pin 46 TXD moved to pin 42 RXD moved to pin 43
    [logic.sch]
2010-05-04 Changed names of the two different I2C busses for greater clarity.
    [logic.sch]
2010-05-04 Removed obsolete pullup resistor on the RST line.
    [logic.sch]
2010-05-04 Added voltage dividers from the connector to the ADC and minor fixes.
    [logic.sch]
2010-05-04 Updated footprints to pretty-eagle-lib.
    [logic.sch]
2010-05-04 Added additional voltage diveders between connectors and ADC and minor fixes.
    [logic.sch]
2010-05-07 Updated the OBLDC_CONN mechanical part in open-bldc.lbr.
2010-05-07 Updated the logic.sch file so that the latest version of the connector is used.
    [logic.sch]
2010-05-11 Added testpads, standard cortex jtag and CAN_SLP.
    Also changed the power supply of the CAN transceiver from 5v to 3v3.
    [logic.sch]
2010-05-13 Added spinup routine and cleanups.
    Cleanups contain some bugfixes in the BEMF zero crossing detection and
    sensor data processing. It is now a real crossing detection and not only
    detection if the BEMF is above or under zero. This way we can now detect
    if a useful BEMF is being seen and we can start trying to lock on that
    signal after spinup.
    [comm_process.c, comm_process.h, comm_tim.c, pwm.c, sensor_process.c]
2010-05-14 Now enabling closed loop control after spinup.
    It works 1 of 3 times to startup the motor up to closed loop. It still
    needs tons of tweaking. Linear interpolation is not enabled yet so that
    may improve things. Also for an unknown reason some zero crossings are
    not being detected, this needs to be addressed too.
2010-05-14 Fixed the bemf detect skip problem.
    [sensor_process.c]
2010-05-14 Added demo mode which will oscillate power up and down.
    [main.c, main.h, sensor_process.c]
2010-05-17 Fixed a bug preventing RPM > 3090
    The variables for calculating new comm time were unsigned that caused an
    overflow and erronous detection of direct cutoff boundries. This caused
    the commutation frequency to never go above (3090/60)*42=2163Hz and
    therefore stalling always at that speed. Next boundry is around 4000rpm
    probably because of holdoff and presampling of the bemf signal.
    [comm_process.c, comm_process.h]
2010-05-18 Increased PWM frequency to 22kHz
2010-05-18 Decreased holdoff (>35000erpm), improved spinup.
    erpm stands for electrical field rpm
    Another reason for the higher electrical rpm is that now we are not
    forcing the bemf detection to lock directly on the bemf crossing signal.
    If there was not enough samples to do the crossing detection directly at
    the crossing we interpolate to the past to calculate when the crossing
    occured.
2010-05-18 Increased the range of the oscillation demo.
    [main.c]
2010-05-18 Added pwm duty cycle slider. Minor cleanups.
2010-05-18 Rewrote phase control output conf code.
    The old code using libstm functions was very inefficient calling a lot
    of functions. Reduced that by reimplementing that as macros that change
    the registers in one step. For now only H pwm L on scheme is ported to
    the new api.
2010-05-19 Copied v0.1 powerstage schematic, will become v0.3
    [power.sch]
2010-06-02 Added encoder connector. Minor cleanups.
    [logic.sch]
2010-06-02 Added smd version of the obldc connector footprint.
2010-06-03 Added power driver board.
    [power_driver.sch]
2010-06-04 Improved fairchild mosfet footprint.
2010-06-04 Finalized the power board circuit.
    [power.sch]
2010-06-04 Added encoder input attentuation.
    [logic.sch]
2010-08-05 Updated governor test firmware to v0.3 hardware.
    It is using the new pins for LED and the remapped PB6 and PB7 pins for
    USART1.
2010-08-05 Updated 32bit timer test to hardware v0.3
2010-08-07 Fixed PWM pin outputs.
    Because of v0.3 hardware changes the GPIOA bank peripheral clock was not
    initialized. (it is not used in the LED module anymore) As in the pwm
    module not all needed peripheral clocks were initialized the GPIOA bank
    clock was untouched. For future reference: each module has to enable
    clocks for all peripherals it uses and not only those that are not
    initialized by other modules... obviously.
    [pwm.c]
2010-08-10 Added multiple target builds to firmware makefile.
    Now the default make all target builds the main motor control firmware
    but running for example "make test_blink.all" compiles the blink
    testcode. Other possible suffixes are .clean and .flash. First
    testprogram that got merged in is blinktest. More to come.
2010-08-10 Merged 32bit timertest into the main firmware build.
2010-08-11 Added source exist check and moved common objects out.
    Using pattern matching targets screws around with gnumake's head. It
    does not detect properly when one of the source files is just missing
    and says that it can not find the requested target instead of reporting
    that the source file is missing. Now added a target that tests if all
    provided source files exist and if not aborts with a proper error
    message.
    Also moved some common source files to COMMON_OBJECTS variable for
    better readability and less repetition/mistake probability. :)
2010-08-11 Moved all *.c files that resemble a driver into drivers subdir.
    Not all of the *.c files in drivers directory are really general "driver" implementations yet. They need to be cleaned from obldc specific things still, but it is a step into the right direction.
2010-08-11 Removed -Ipwm and -Idriver from gcc params.
    Now when refering to a driver or pwm header file it needs to be prefixed with driver/ and pwm/ respectively. It makes it more clear what they are when reading the code.
2010-08-13 Added sys_tick driver and associated test.
2010-08-17 Added sensor process documentation
2010-08-17 Fixed pwm scheme documentation using verbatim.
    [pwm_scheme_12step_pwm_on_pwm.c, pwm_scheme_6step_h_on_l_pwm.c, pwm_scheme_6step_h_pwm_l_on.c, pwm_scheme_6step_on_pwm.c, pwm_scheme_6step_pwm_on.c]
2010-08-18 Documented drivers.
2010-08-18 Documented the PWM subsystem.
2010-08-18 Added more soft timer callback functionality.
2010-08-19 Removed the requirement to set [C|LD]FLAGS for arm crosscompile.
2010-08-20 Added documentation and fixed logic bug in control_process.c.
    [control_process.c, cp_aligning.c, cp_spinup_2step.c]
2010-08-20 Fixed state transition from coarse to fine state in cp_spinup_2step.c
    [cp_spinup_2step.c]
2010-08-20 Fixed state naming typo.
    [control_process.c, control_process.h]
2010-08-20 Fixed callback return code.
    [cp_spinup_2step.c]
2010-08-21 Added soft timer based spinup implementation.
2010-08-21 Moved stuff around.
    Now drivers and tests are in toplevel directory to clean things up.
2010-08-21 Added strategy selection for mc target.
    Still not really good because when switching strategies the resulting
    binaries are not being rebuilt, but it works for now.
2010-08-24 Some work on soft timer spinup.
    Seems to work repetitively now. It probably needs some polish but it is
    already way better then the 2step.
    Also added fixed point fraction of the timer value for smoother calculations
    of new commutation times.
    [cp_aligning.c, cp_idle.c, cp_spinup_soft_timer.c, mc_main.c, sys_tick.c]
2010-08-26 Cleaned up obldc connector footprint.
2010-08-26 Readded lost obldc mechanical footprint.
2010-08-26 Updated the cream layer of the power33 mosfet packages.
2010-08-26 updated v0.3 power stage circuit.
    [power.sch]
2010-08-27 Fixed align state. Now it actually works again.
    [cp_aligning.c]
2010-08-27 Fixed transition out callback handling in control process.
    If the state of the control process got changed outside of a callback
    the transition to the new state was not detected and the transition out
    and transition in callbacks were ignored. Fixed.
    [control_process.c]
2010-08-27 Added spinup hold time in soft timer spinup + tuning.
2010-08-27 Added simple hardware based bemf detection implementation.
    This is really only a simple test. It has to morph into something
    usable. It is toggleling orange led every time a bemf zero transition
    occurs.
2010-08-28 Changed hardware bemf pins to input pullup mode.
    The comparator is open drain. It needs a pullup to work.
    Note: On the hardware the voltage dividers for bemf and star voltage
    have to be removed, and the bemf upper resistors replaced with jumpers.
    This is needed so that the signals have the right voltages and create a
    50% duty cycle when added.
    [bemf_hardware_detect.c]
2010-09-07 Removed double bool def, added NULL fixed some lint warns.
    [exceptions.c, types.h]
2010-09-07 Fixed some more lint errors.
    [adc.h, gprot.h, mc_main.c, usart.c]
2010-09-07 Some more lint error fixes.
    [adc.c, adc.h, comm_tim.c, cpu_load_process.c, governor_main.c, gprot_test_governor.c, led.c, pwm.c]
2010-09-07 Another batch of lint fixes.
    [comm_process.h, comm_process_sampling.c, comm_tim.c, control_process.h, cp_aligning.c, cp_error.c, cp_idle.c, cp_spinning.c]
2010-09-07 Fixed all remaining lint errors for mc target.
    [bemf_hardware_detect.c, comm_process_sampling.c, comm_tim.h, control_process.c, control_process.h, cp_aligning.c, cp_aligning.h, cp_error.c]
2010-09-07 Fixed 2step spinup strategy after recent cleanups.
    [cp_spinup_2step.c]
2010-09-07 Fixed lint errors for 2step spinup strategy.
    [cp_spinup_2step.c]
2010-09-07 Fixed all lint warnings for all remaining targets.
    [32bit_tim.c, 32bit_tim.h, 32bit_tim_main.c, 32bit_tim_ref_tim.c, blink_main.c, governor_main.c, gprot_test_governor.c, sys_tick_main.c]
2010-09-08 Moved bemf hardware detect to drivers where it belongs.
2010-09-08 Initializing properly pwm output.
    Without at least one setup of pwm at the very beginning the first run of
    ignite was not aligning the motor. Now it does.
2010-09-08 Added trigger and data output from bemf hd driver.
2010-09-08 Resetting the comm process trigger now.
    [mc_main.c]
2010-09-08 Moved comm_process params into the strategy.
    The parameters are responsibility of the strategy and should be private.
    They are now. That exposes a new problem. If you expose the parameters
    using the governor protocol interface the qgovernor software has to be
    informed about the register names. It has to be addressed in the future.
    [comm_process.h, comm_process_sampling.c]
2010-09-08 Removed led indicators from bemf hd driver.
2010-09-08 Fixed type cast, comm_tim_data.freq is u16 not u32.
    [comm_process_sampling.c]
2010-09-09 Switching yamlgenconf to C++, added drafts of config classes.
2010-09-11 Fixed static_cast in RegisterConfigHeaderRunner
    [register_config_header_runner.cpp]
2010-09-12 Updated onepiece design to the newest version.
    [onepiece.brd, onepiece.sch]
2010-09-12 Interface polish, added postprocessor stage for yamlgenconf
2010-09-13 Added new debug pins driver.
    This driver "misuses" I2C and encoder pins as debug outputs that you can
    switch ON, OFF and Toggle just like the LED outputs.
2010-09-13 Fixed some warnings on Mac OS X.
    The Mac OS X compiler complaining about uncasted non int params to %d
    printf.
    [error_handling.cpp]
2010-09-14 Added debug pins driver to mc main.
2010-09-17 Completely disabled adc driver in mc target for now.
2010-09-17 Now switching to closed loop when detecting valid bemf signal.
    Also decreased startup power and switched off "safe for closed loop
    startup frequency" check that seems to be unnecessary... decreased
    closed loop comm frequency lowpass coefficient.
2010-09-17 bemf_line_state now global to decrease interrupt handler process time.
2010-09-18 Made hardware bemf led output configurable.
2010-09-21 Made PWM frequency adjustable through main config file.
2010-09-21 Upgraded pwm_on_pwm scheme to the new api and made available.
2010-09-21 Decreased pwm frequency to 16kHz.
    The power values are still dependent on the pwm frequency and need to be changed every time to match the current pwm frequency setting. FIXME
2010-09-21 Added PWM_SCHEME_12STEP indicator which changes the calculated commutation time divider to match the 12 steps.
    This is necessary to make 12step schemes work.
2010-09-21 Updated all remaining PWM schemes to the new API and reenabled.
2010-09-21 Some minor comment typo fixes.
    [pwm_scheme_12step_pwm_on_pwm.c, pwm_scheme_6step_h_on_l_pwm.c, pwm_scheme_6step_on_pwm.c, pwm_scheme_6step_pwm_on.c]
2010-09-22 Fixed PWM timer CCER register mask.
    [pwm_utils.h]
2010-09-22 Added spark advance to hardware closed loop and made iir filter runtime configurable.
2010-09-22 Made the PWM subsystem output power independent from frequency. It is a full 16bit value now.
2010-09-22 Improved commutation frequency aquisition.
    If bemf jitters using the last transition as the time we calculate the
    frequency from and still using the first transition as the end of the
    measurement period. This will force the closed loop to speed up enough
    to get rid of most of the jitter. The jitter is caused mostly by bemf
    going under 0V on a phase that is still powered. That happens only when
    the rpm is not matching the drive power.
    [bemf_hardware_detect.c, comm_tim.c, comm_tim.h]
2010-09-29 Switched yamlgen and olconfgen makefiles to libtool.
    Now both can be easily built on Mac OS X now!!!
2010-10-03 Switched over from a static config.h to olconfgen generated one.
2010-10-13 Added DirectFED-MN and DPak mosfet packages.
2010-10-13 Added MLP1 footprint and FDMS5352 mosfet.
2010-10-18 Added Hirose DF9 series 15 pin connector.
2010-10-19 Updates and fixes to olconfgen test.
    * Changed test output to a unified diff
    * Updated expected test output to the newest version
    * Removed test_output.hpp which is generated by the test and should not
    be in the repository
    [expected_main.hpp]
2010-10-19 Improved the global makefile. It is now doing a more complete job.
    It is now compiling summon-arm-toolchain, autogening libgovernor and
    configuring it. It still is doing things every time you run make that
    should be done only once, so there is space for improvement.
2010-10-19 Added summon-arm-toolchain patch used when building with global make.
2010-10-20 Removed summon arm toolchain from the global makefile again.
2010-10-21 Added preliminary castle logic circuit.
    [clogic.sch]
2010-10-21 Improved current sensing circuit to measure forward and backward current.
    [clogic.sch]
2010-10-21 Added thermistor to clogic.
    [clogic.sch]
2010-10-22 Added RPM output to qgovernor bldc tab.
2010-10-26 Updated clogic circuit to the newest version.
    [clogic.sch]
2010-10-29 Now we are able to compile using libc finally.
    Using arm-none-eabi-ld as linker results in an error that libgcc.a can not be found. The reason is that ld does not provide the library search paths. You need to use arm-none-eabi-gcc as a wrapper that provides the library search paths to the linker.
    Enabled stripping of debug symbols from libc libgcc and libm as we were already at it.
    For some wered reason I had to reenable adc driver again because now it complains about it.
2010-11-03 Added octave script for current sensing circuit calculations.
2010-11-03 Got really near to what we want in shunt sense circuit value calculation.
2010-11-12 Fixed bemf led output selection defines to work with olconfgen.
    [bemf_hardware_detect.c]
2010-11-12 Updated the led pinout to match clogic.
    We really need some hardware configuration selection mechanism by now.
2010-11-15 Use stm32x mass_erase instead of flash_write erase. It is faster this way.
2010-11-16 Fixed display of spark advance which is a signed value.
    [mainwindow.cpp, registermodel.cpp]
2010-11-16 PWM duty cycle is a signed value now.
2010-11-17 Added interval markers to the power slider.
2010-11-17 Added braking to pwm on scheme.
2010-11-18 Updated clogic v0.1 schematic to the newest version.
    [clogic.sch]
2010-11-18 Added clogic v0.2 schematic.
    [clogic.sch]
2010-11-18 Implemented rail voltage, current and temperature sensing.
    Doing that removed most of the lowlevel phase voltage sensing stuff. As
    sampling based control was not really working after all it needs to be
    reimplemented anyways. We may add the functionality for that using ADC2
    later anyways.
2010-11-18 Renamed pwm_dir to pwm_mode (drive/brake) to distinguish from driving actually backwards that needs to be added later.
2010-12-05 Basic implementation of a CAN driver, works talking to LISA/L.
    A test program is also included. Still having issues of having two motor
    controllers talk to each other. Needs to be tested with more then one
    controller on the bus.
    [can.c, can.h, can_main.c]
2010-12-30 Ported led driver and test_blink to libopencm3.
2010-12-30 Ported usart test and driver to libopencm3.
2010-12-30 Ported systick test and driver to libopencm3.
2010-12-30 Ported CAN test and driver to libopencm3
2011-01-12 Needed to increase the startup power. Because it was unreliable with the low value.
2011-02-04 Moved stm32 version of libgovernor when built with global makefile to arm-none-eabi subdirectory to make it not clash with the host version of the same library.
2011-02-22 Change qgovernor to use the libgovernor in the stage directory.
2011-02-22 Initial port of mc firmware to libopenstm32. Still missing ADC and will need some additional fixes to be fully operational.
    [adc.c, bemf_hardware_detect.c, comm_tim.c, control_process.h, cpu_load_process.c, led.h, mc_main.c, pwm.c]
2011-03-19 Added a board configuration file included by other configs. For now it contains only the external clock speed used on the specific board, and is fixed to clogic v1.1 but can be extended to other boar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
    [blink_main.c, can_main.c, debug_pins_main.c, governor_main.c, mc-config.yaml, mc_main.c, mcu.c]
2011-03-20 Added get version callback in client code.
    This enables the client to attach it's own firmware version information
    to the libgovernor version.
2011-03-21 Corrected path to the firmware stage library and include directories. (libgovernor for stm32 got moved to arm-none-eabi subdirectory earier)
2011-03-21 Added flags to libgovernor so that the multilib arm cross compiler selects the right version of libraries.
2011-03-24 Added version reporting to the regular motor control firmware.
2011-04-04 Added support to use black magic probe for flashing.
2011-04-04 Improved black magic probe gdb script and makefile target.
2011-04-04 Added debug target using black magic probe.
2011-04-04 Forgot to add the black magic probe debug script. So here we go! :)
2011-04-05 Fixed a typo in the black magic probe flash target.
2011-04-11 Implemented preliminary i2c1 and external flash drivers.
    A small read write test is implemented inside the governor test program.
    It needs to be split out into it's own test to not contaminate the
    purpose of the governor test.
2011-04-18 Added layout files of obldc board v0.3.
    [logic.brd, power.brd, power_driver.brd]
2011-04-18 Added v0.2 obldc board design files.
    [logic.brd, logic.sch, pstage.brd, pstage.sch]
2011-04-18 Added clogic v0.1 board design file.
    [clogic.brd]
2011-04-18 Added clogic v0.2 design files.
    [clogic.brd, clogic.sch]
2011-04-18 Added clogic v0.3 design files.
    [clogic.brd, clogic.sch]
2011-04-18 Added clogic v1.1 board design files.
    [clogic.brd, clogic.sch]
2011-04-18 Initial commit of cpico power v0.1 board.
    [cpico_power.brd, cpico_power.sch]
2011-04-18 First stab at routing the half bridges.
    [cpico_power.brd, cpico_power.sch]
2011-04-19 Added some more comments to the flash driver.
2011-04-19 Created new test dedicated to ext_flash driver.
2011-05-03 Some more routing work on cpico_power.
    [cpico_power.brd, cpico_power.sch]
2011-05-08 Stabbing deeper and twisting on the cpico power layout. :)
    [cpico_power.brd, cpico_power.sch]
2011-05-08 Finished routing cpico power. No airwires left. Minor cleanup/review needed.
    [cpico_power.brd]
2011-05-31 Added BEMF signals to the PWM-Scheme svg diagrams, for additional clarity.
2011-05-31 Added separate resistors and ferrite beads for each gate for better gate charge management.
    [cpico_power.brd, cpico_power.sch]
2011-05-31 Consolidated and improved the PWM Scheme and BEMF illustrations.
2012-07-01 Removing hardware subdirectory. Hardware can now be found in the open-bldc-hardware repository.
    [clogic.brd, clogic.sch, cpico_power.brd, cpico_power.sch, gsch2pcb.cfg, jtag_adapter.brd, jtag_adapter.sch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]
2012-07-01 Removing hardware subdirectory as it got split out into open-bldc-hardware repository.
    [clogic.sch, gsch2pcb.cfg, jtag_adapter.brd, jtag_adapter.sch, layout.cfg, logic.brd, logic.sch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]
2012-07-01 Improved the ext flash driver architecture to be more a useful driver then just quick test hack.
2012-07-01 Added BEMF signal to the PWM scheme diagrams.
